mcu786/daGloane/HW/eagle/daGloane_layout.png

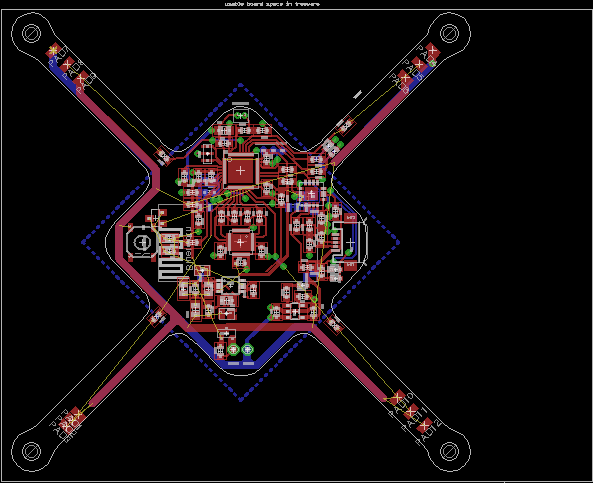
HW/eagle/daGloane_layout.png
