mcu786/daGloane/HW/BOM_abschätung.ods

BOM Micro Quad
Nr. | Part | Description | Count | Unit Price | Price
1 | STM32 | µC | 1 | 5,11 € | 5,11 € | www.digikey.com
2 | MPU6000 | 3-Axis Gyro, 3-Axis ACC | 1 | 25,00 € | 25,00 € | www.lipoly.de
3 | D1000 | 2g Brushless Motor | 4 | 6,00 € | 24,00 € | www.hobbycity.com
4 | 3“x2“ Prop | 2x linksdrehen & 2x rechtsdrehend | 4 | 0,79 € | 3,16 € | www.lipoly.de
5 | PCB | 30cent/cm² + 1,5€ versand: A= 25cm² | 1 | 9,00 € | 9,00 € | mikrocontroller.net platinensammler
6 | Stencil | SMD Stencil | 1 | 13,50 € | 13,50 € | http://www.smtstencil.co.uk/
7 | MTD6505 | Integrated Brushless DC controller IC | 4 | 1,19 € | 4,76 € | www.digikey.com
8 | LIPO | 350mAh | 1 | 3,50 € | 3,50 € | www.hobbycity.com
9 | Empfänger | Bluetooth? | 1 | 7,29 € | 7,29 € | www.ebay.de
10 | Dubwise | Android bluetooth RC app | 1 | 0,00 € | 0,00 €
11 | PTS525 | Tactile Switch | 1 | 0,71 € | 0,71 € | www.digikey.com
12 | FT230 | USB-to-UART | 1 | 2,28 € | 2,28 € | www.digikey.com
13 | MCP73831 | USB-Lipo-Lade-IC | 1 | 0,69 € | 0,69 € | www.digikey.com
14 | MCP1252-33X50I/MS | ChargePump | 1 | 1,63 € | 1,63 € | www.digikey.com
15 |  |  |  |  | 0
16 |  |  |  |  | 0
17 |  |  |  |  | 0
Total |  |  |  |  | 100,63 €
