mcu786/daGloane/HW/CAD/PCB3.dxf

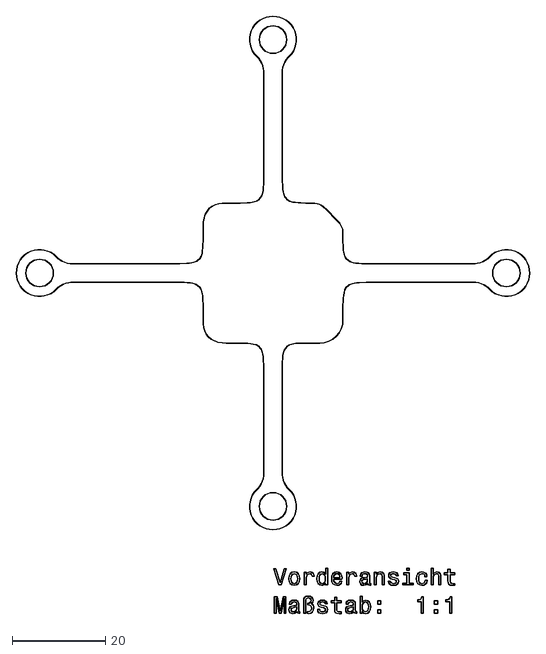
[picture p3: CAD file, 2012-05-13]
HW/CAD/PCB3.dxf
110.0 x 128.0
