mcu786/daGloane/HW/CAD/PCB4.dxf

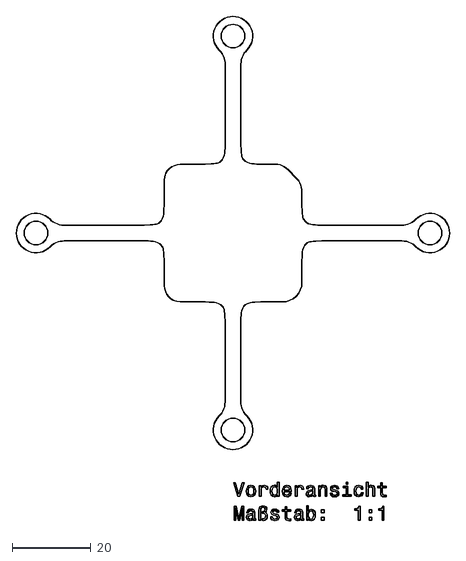
[picture p4: CAD file, 2012-05-13]
HW/CAD/PCB4.dxf
110.0 x 128.0
