mcu786/daGloane/HW/CAD/pcb.dxf

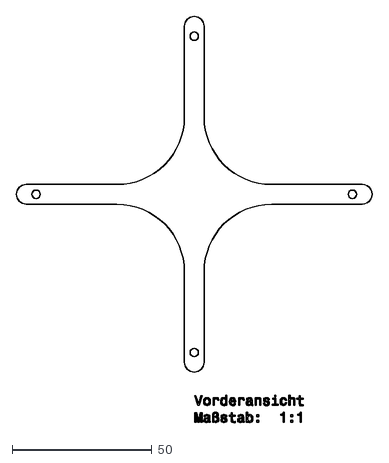
[picture p5: CAD file, 2012-05-13]
HW/CAD/pcb.dxf
127.4 x 145.3
