mcu786/daGloane/HW/CAD/pcb2.dxf

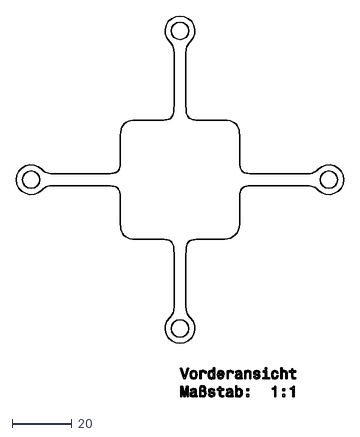
[picture p6: CAD file, 2012-05-13]
HW/CAD/pcb2.dxf
110.0 x 128.0
