mcu786/daGloane/(commit log)

2012-05-11 inital commit of daGloane schematic
    [daGloane.brd, daGloane.sch]
2012-05-11 USB2UART interface replaced MPU6000 added
    [daGloane.brd, daGloane.sch]
2012-05-12 package size of passive components reduced to 0603 dual LED replaced by standart LEDs in 0805 package
    [daGloane.brd, daGloane.sch]
2012-05-12 -MCP1252 added: Low Noise, Positive-Regulated Charge Pump (Lipo 3..4.2V -> 3.3V) -MCP73831 added: Single Cell, Fully Integrated Li-Ion,Li-Polymer Charge Management Controller (USB Batterie Charging)
    [daGloane.brd, daGloane.sch]
2012-05-12 tacticle switch and nesessacy circuitry for power on/off added. leakage current might become an issure..
    [daGloane.brd, daGloane.sch]
2012-05-12 reset buttom removed.
    [daGloane.brd, daGloane.sch]
2012-05-12 board outline imported from dxf
    [daGloane.brd]
2012-05-12 STM32 replaced by derivate with a smaller footprint: VFQFPN36
    [daGloane.brd, daGloane.sch]
2012-05-12 MotorPower switch added to reduce current consumption when turned off.
    [daGloane.brd, daGloane.sch]
2012-05-13 Boad outlines for hextronik BLDC motor and X-Twin DC Motor
    [daGloane.brd, pcb.dxf, pcb2.dxf]
2012-05-13 another pcb outline added
    [PCB3.dxf, PCB4.dxf, daGloane.brd]
2012-05-15 package outline for MPU600 package added
    [daGloane.brd, daGloane.sch]
2012-05-17 pin assignment of µC changed pwm outputs for the motors are now on PB0,PB1,PB4 and PB5. Those I/Os can be used with TIM3
    [daGloane.brd, daGloane.sch]
2012-05-18 gnd removed
    [daGloane.brd, daGloane.sch]
2012-05-18 all non standart part replaced by parts found in the daGloane.lbr library
    [daGloane.brd, daGloane.sch]
2012-05-18 micro USB b connector added to daGloane lbr
    [daGloane.brd, daGloane.sch]
2012-05-18 tactile switch added
    [BOM_abschätung.ods]
2012-05-18 several parts added
    [BOM_abschätung.ods]
2012-05-21 Added Bluetooth module
    [daGloane.sch]
2012-05-21 Splitted schematic in Frames
    [daGloane.sch]
2012-05-21 Bluetooth module added
    [BOM_abschätung.ods]
2012-05-21 replicate entry removed
    [BOM_abschätung.ods]
2012-05-21 schematic preview image. - it is easier to see the difference between two revision in an image of the schematic
2012-05-21 reset to actual schematic
2012-05-21 added bluetooth
    [daGloane.brd]
2012-05-21 missing connection uart connection to bluetooth module fixed
    [daGloane.brd, daGloane.sch]
2012-05-21 2 descrete diodes replaced by one part containing to diodes
    [daGloane.brd, daGloane.sch]
2012-05-22 MTD6501C brushless driver IC added to lib
2012-05-22 frame with bldc drive version added to schematic
    [daGloane.brd, daGloane.sch]
2012-05-22 N MOSFET IRLML6344TRPbF added to lib
2012-05-22 DC motor drive added to schematic
    [daGloane.brd, daGloane.sch]
2012-05-22 gnd connection of decoppling capacitors of BLDC motor drivers changed to mot_gnd
    [daGloane.brd, daGloane.sch]
2012-05-23 positionering of BLDC Conectors
2012-05-28 led added to LiPo charge IC
    [daGloane.brd, daGloane.sch]
2012-05-28 - PI filter added to charge pump DC/DC - trough hole pads for BLDC motors replaced with SMT type pads
    [daGloane.brd, daGloane.sch]
2012-05-29 100nF capacitor added to PI filters of charge pump dc/dc series resistors of spi resized to 150R
    [daGloane.brd, daGloane.sch]
2012-05-30 jumper package with 50mil pitch added
2012-05-30 bootmode jumper replaced with 50mil pitch type
    [daGloane.brd, daGloane.sch]
2012-06-01 cosmetic changes
    [daGloane.sch]
2012-06-01 brushed DC motor driver stage removed
    [daGloane.brd, daGloane.sch]
2012-06-01 wirepad footprint added to lib
2012-06-01 wirepads for connecting the BLDC motors replaced with newly created smaller ones
    [daGloane.brd, daGloane.sch]
2012-06-01 New outline with wider arms added. The BLDC driver ICs fit on the arms now.
    [daGloane.brd, daGloane.sch]
2012-06-02 some pins of MC exchanged to ease layouting
    [daGloane.sch]
2012-06-02 part positiont for layout some traces routed
    [daGloane.brd]
2012-06-03 minor change
    [daGloane.sch]
2012-06-03 some routing done. 127 unrouted traces left
    [daGloane.brd]
2012-06-03 draft outlines remove
    [daGloane.brd]
2012-06-03 motor driver layout
    [daGloane.brd, daGloane.sch]
2012-06-10 changed layout(usb)
    [daGloane.brd]
2012-06-10 changed layout (usb)
    [daGloane.brd]
2012-06-11 dummy symbol added for 3A BLDC Controller
2012-06-11 BLDC driver ICs removed dummy symbol for 3A BLDC Controllers added
    [daGloane.brd, daGloane.sch]
2012-06-11 voltage divider layout done
    [daGloane.brd]
2012-06-11 power-on-uC signal rewired to pin 17 of uC
    [daGloane.sch]
2012-06-11 reduced footprint for uart only operation of bluetooth module created
2012-06-11 bluetooth module replaced with reduced pad version
    [daGloane.sch]
2012-06-11 uart connection of bluetooth module routed
    [daGloane.brd]
2012-07-07 FT230X layout finished BLDC power line layout started
    [daGloane.brd, daGloane.sch]
